Sorsly/ringRemote/datasheets/power.ods

state | component | current draw (A) | voltage (V) | time duration (ms) | comments | Continuous total life w/ 5.5mAh (h) | max number of transmissions
tx | ATBTLC1000-ZR | 6.20E-03 | 1.8 | 10 | 3dBm on ch37 | 0.498278673672767 | 179380.322522196
 | PIC12 | 5.80E-05 | 1.8 |  | D015 mode. E: Crap, doesn’t have UART with hardware flow control. Required.
 | MAX32660 |  |  |  | dynamic current, active and deep sleep mode. Has UART with hardware flow control, can use an ultra-low power nanoring osc
 | Lite-On LED | 4.78E-03 |  | 1
idle
