Sorsly/ringRemote/mech/Backup (1) of ringRemote.SLDASM

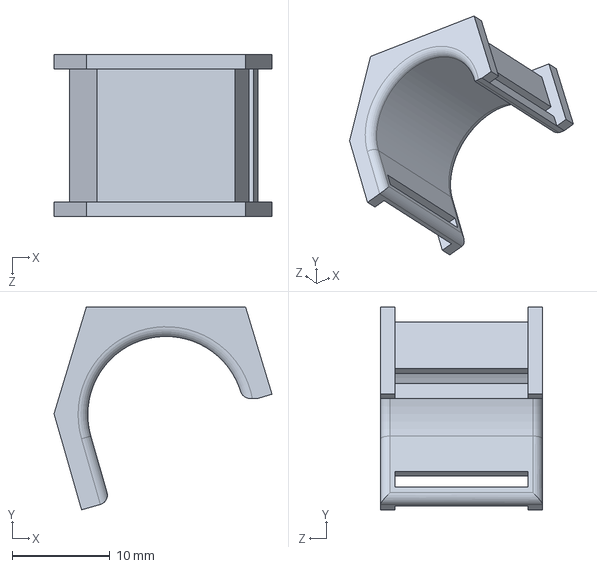
[picture p1: CAD file, 2019-02-18]
mech/Backup (1) of ringRemote.SLDASM
22.3 x 20.8 x 16.6 mm
