Sorsly/ringRemote/mech/Assem1.SLDASM

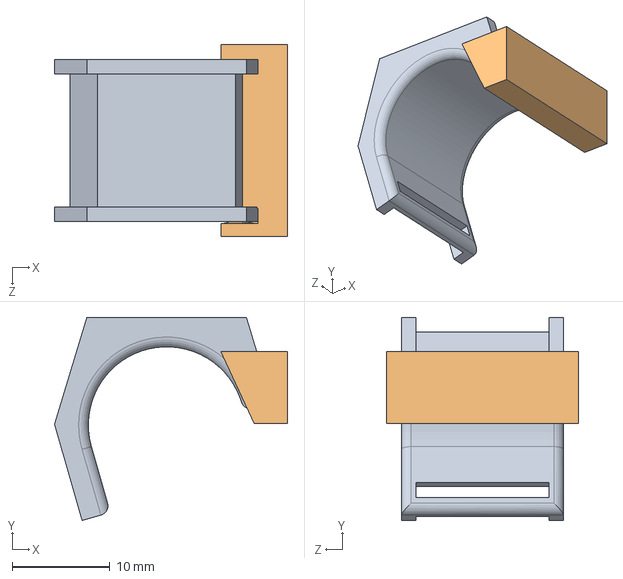
[picture p2: CAD file, 2019-02-18]
mech/Assem1.SLDASM
23.8 x 20.8 x 19.6 mm
tempStand
