Sorsly/ringRemote/mech/Backup (1) of tempStand.sldprt

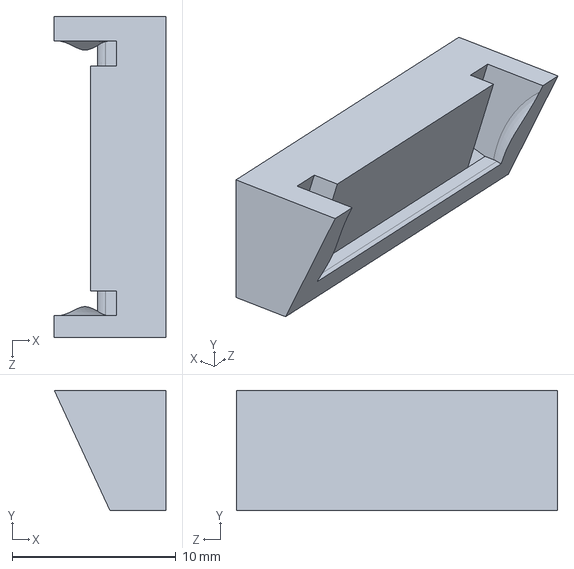
[picture p3: CAD file, 2019-02-18]
mech/Backup (1) of tempStand.sldprt
6.81 x 7.35 x 19.6 mm
