Sorsly/ringRemote/models/Conn_Amphenol_10118192-0001LF/9edb737dc0cf094d5b80fefa4222fe64e3edb863.step

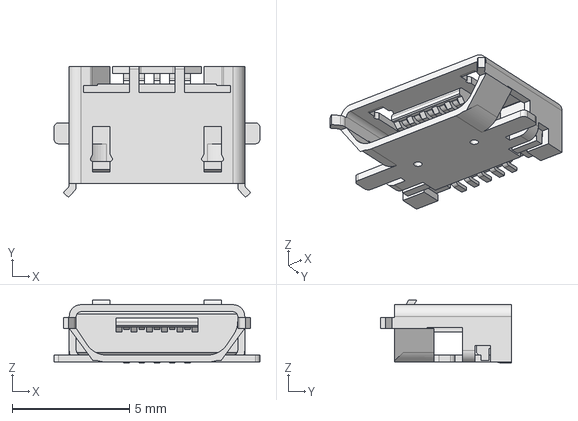
[picture p4: CAD file, 2019-01-07]
models/Conn_Amphenol_10118192-0001LF/9edb737dc0cf094d5b80fefa4222fe64e3edb863.step
8.80 x 5.59 x 2.67 mm
