Sorsly/ringRemote/models/Diode_Panasonic_DB2J31400L/6dc355337178d18dbc62b4daa5e0440a51f9a382.step

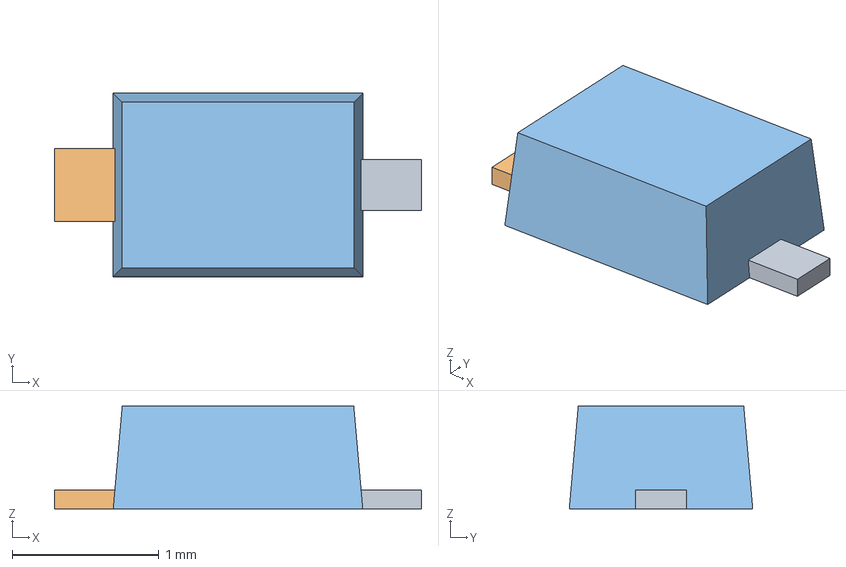
[picture p5: CAD file, 2019-01-07]
models/Diode_Panasonic_DB2J31400L/6dc355337178d18dbc62b4daa5e0440a51f9a382.step
2.50 x 1.25 x 0.7 mm
