Sorsly/ringRemote/models/IC_Microchip_PIC12F1501-I_MS/42fe51aefd6d4e30dba15b1fc3f1184283acede2.step

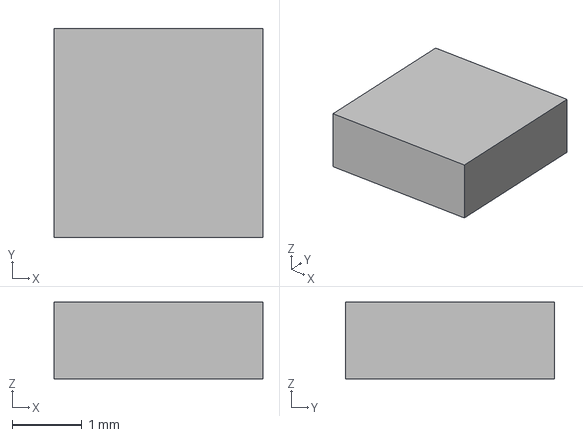
[picture p6: CAD file, 2019-01-06]
models/IC_Microchip_PIC12F1501-I_MS/42fe51aefd6d4e30dba15b1fc3f1184283acede2.step
3.00 x 3.00 x 1.10 mm
