Sorsly/ringRemote/(list of files, cad)

Other CAD files:
mech/Backup (3) of ringRemote.SLDASM
mech/Backup (2) of ringRemote.SLDASM
mech/ringRemote.SLDASM
mech/Part2.SLDPRT
mech/Part1.sldprt
mech/tempStand.sldprt
mech/Backup (2) of tempStand.sldprt
models/IC_Microchip_PIC12F1501-I_MS/c4145753d60ecc28152f750d2ed054111b1eff16.step
mech/stl/ringRemote.STL
mech/tempStand.STL
