Sorsly/ringRemote/kicad/pdf/bottomLayer.pdf

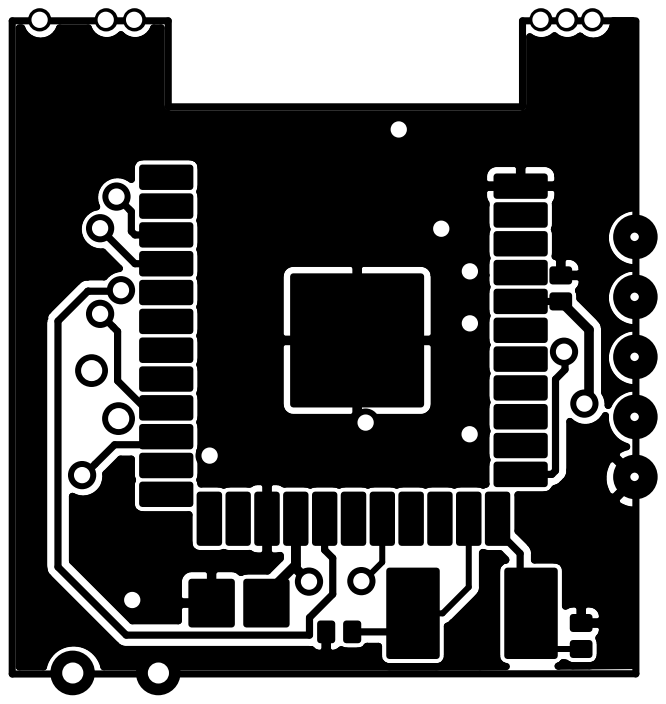
[picture p7: page 1]
