Sorsly/ringRemote/kicad/pdf/hmi2.pdf

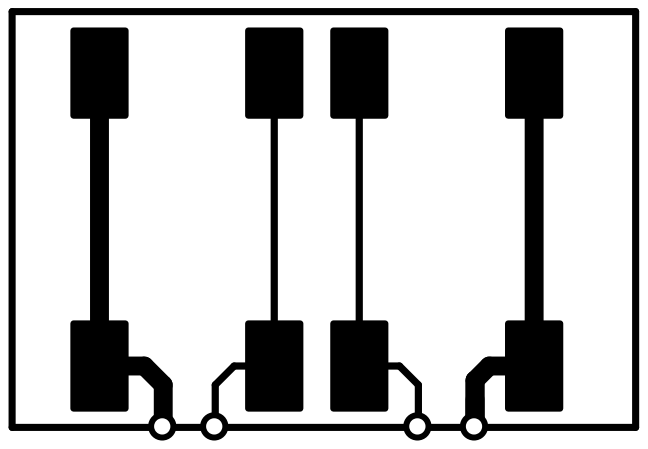
[picture p10: page 1]

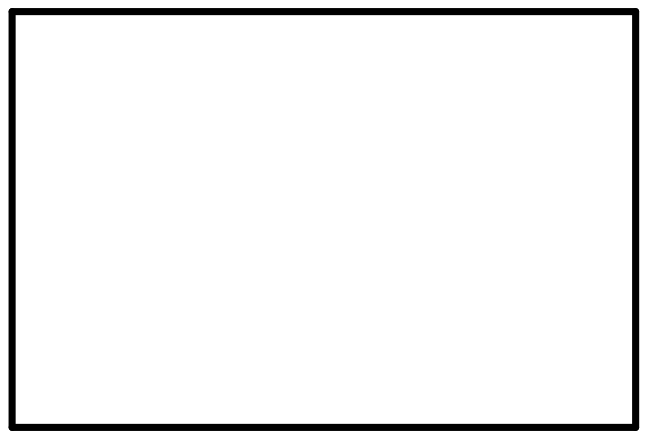
[picture p11: page 2]
