Sorsly/ringRemote/kicad/ringRemote.kicad_pcb

## KiCad design kicad/ringRemote.kicad_pcb (2019-02-18)

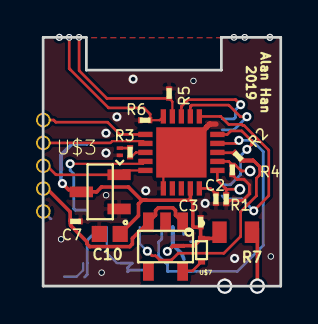
[picture p12: board ringRemote.kicad_pcb from above]

Board: 4 copper layers, 13.2 x 13.8 mm, 23 parts (0 on the bottom side), 24 nets.

Parts:
C2, C3, C7: 1uF; 0201
C4: 0.1uF; 0201
C5, C6: 4pF; 0201
C9, C10: 10uF; 0402
D1: ORANGE; LED-0201
R1, R2, R3, R4, R5, R6: 100k; 0201
R7: 1.8k; 0805
U$1: MAX32660; T2044+5C
U$2: ATBTLC1000-ZR110CA
U$3: TPS3839G25; 3-SOT-23
U$4: TLV700; SOT-23-THIN
U$6: 1X5_1.27MM
U$7: DB2731400L; SSSMINI2
Y1: 32.768kHz; CRYSTAL-SMD-3.2X1.5MM

Connections:
+5V: C7.1, U$4.P$1, U$4.P$3, U$6.P$2
/AO_GPIO_0_WAKE: U$1.P$4, U$2.P$1
/BT_CTS: U$1.P$15, U$2.P$20
/BT_RTS: U$1.P$16, U$2.P$21
/BT_RXD: U$1.P$18, U$2.P$14
/BT_TXD: U$1.P$17, U$2.P$15
/CLKSRC: C6.1, U$2.P$33, Y1.P$1
/C_EN: R2.2, U$1.P$13
/MAXRST: U$1.P$5, U$3.P$2, U$6.P$3
/PB1: R1.1, U$1.P$11
/PB2: R4.1, U$1.P$12
/PB3: R5.1, U$1.P$19
/PB4: R6.1, U$1.P$20
/SWDCLK: U$1.P$1, U$6.P$5
/SWDIO: U$1.P$2, U$6.P$4
/WAKEMONITOR: U$1.P$14, U$2.P$28
GND: C2.2, C3.2, C4.2, C5.2, C6.2, C7.2, C9.2, C10.2, D1.C, R1.2, R4.2, R5.2, R6.2, U$1.P$0, U$1.P$6, U$2.P$11, U$2.P$26, U$2.P$35, U$3.P$1, U$4.P$2, U$6.P$1
unnamed: C2.1, U$1.P$10
unnamed: C5.1, U$2.P$34, Y1.P$2
unnamed: D1.A, R3.2
unnamed: R2.1, U$2.P$30
unnamed: R3.1, U$1.P$3
unnamed: U$4.P$5, U$7.P$2
VCC: C3.1, C4.1, C9.1, C10.1, R7.2, U$1.P$9, U$2.P$7, U$2.P$27, U$3.P$3, U$7.P$1
