Sorsly/ringRemote/kicad/hmi1.kicad_pcb

## KiCad design kicad/hmi1.kicad_pcb (2019-01-25)

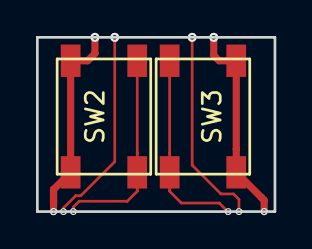
[picture p13: board hmi1.kicad_pcb from above]

Board: 2 copper layers, 13.2 x 9.7 mm, 3 parts (0 on the bottom side), 3 nets.

Parts:
FRAME1: FRAME-LETTERNO_PACKAGE; DUMMY
SW2, SW3: SW_SPST_0; RS-187R05A2-DS MT RT

Connections:
/PB2: SW3.1, SW3.2
/PB3: SW2.1, SW2.2
VCC: SW2.3, SW2.4, SW3.3, SW3.4
