Sorsly/ringRemote/kicad/hmi2.kicad_pcb

## KiCad design kicad/hmi2.kicad_pcb (2019-01-24)

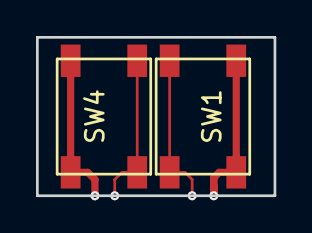
[picture p14: board hmi2.kicad_pcb from above]

Board: 2 copper layers, 13.2 x 8.8 mm, 3 parts (0 on the bottom side), 3 nets.

Parts:
FRAME1: FRAME-LETTERNO_PACKAGE; DUMMY
SW1, SW4: SW_SPST_0; RS-187R05A2-DS MT RT

Connections:
/PB1: SW1.1, SW1.2
/PB4: SW4.1, SW4.2
VCC: SW1.3, SW1.4, SW4.3, SW4.4
