Sorsly/ringRemote/eagle/ringRemote.brd

## EAGLE design eagle/ringRemote.brd (2019-01-21)

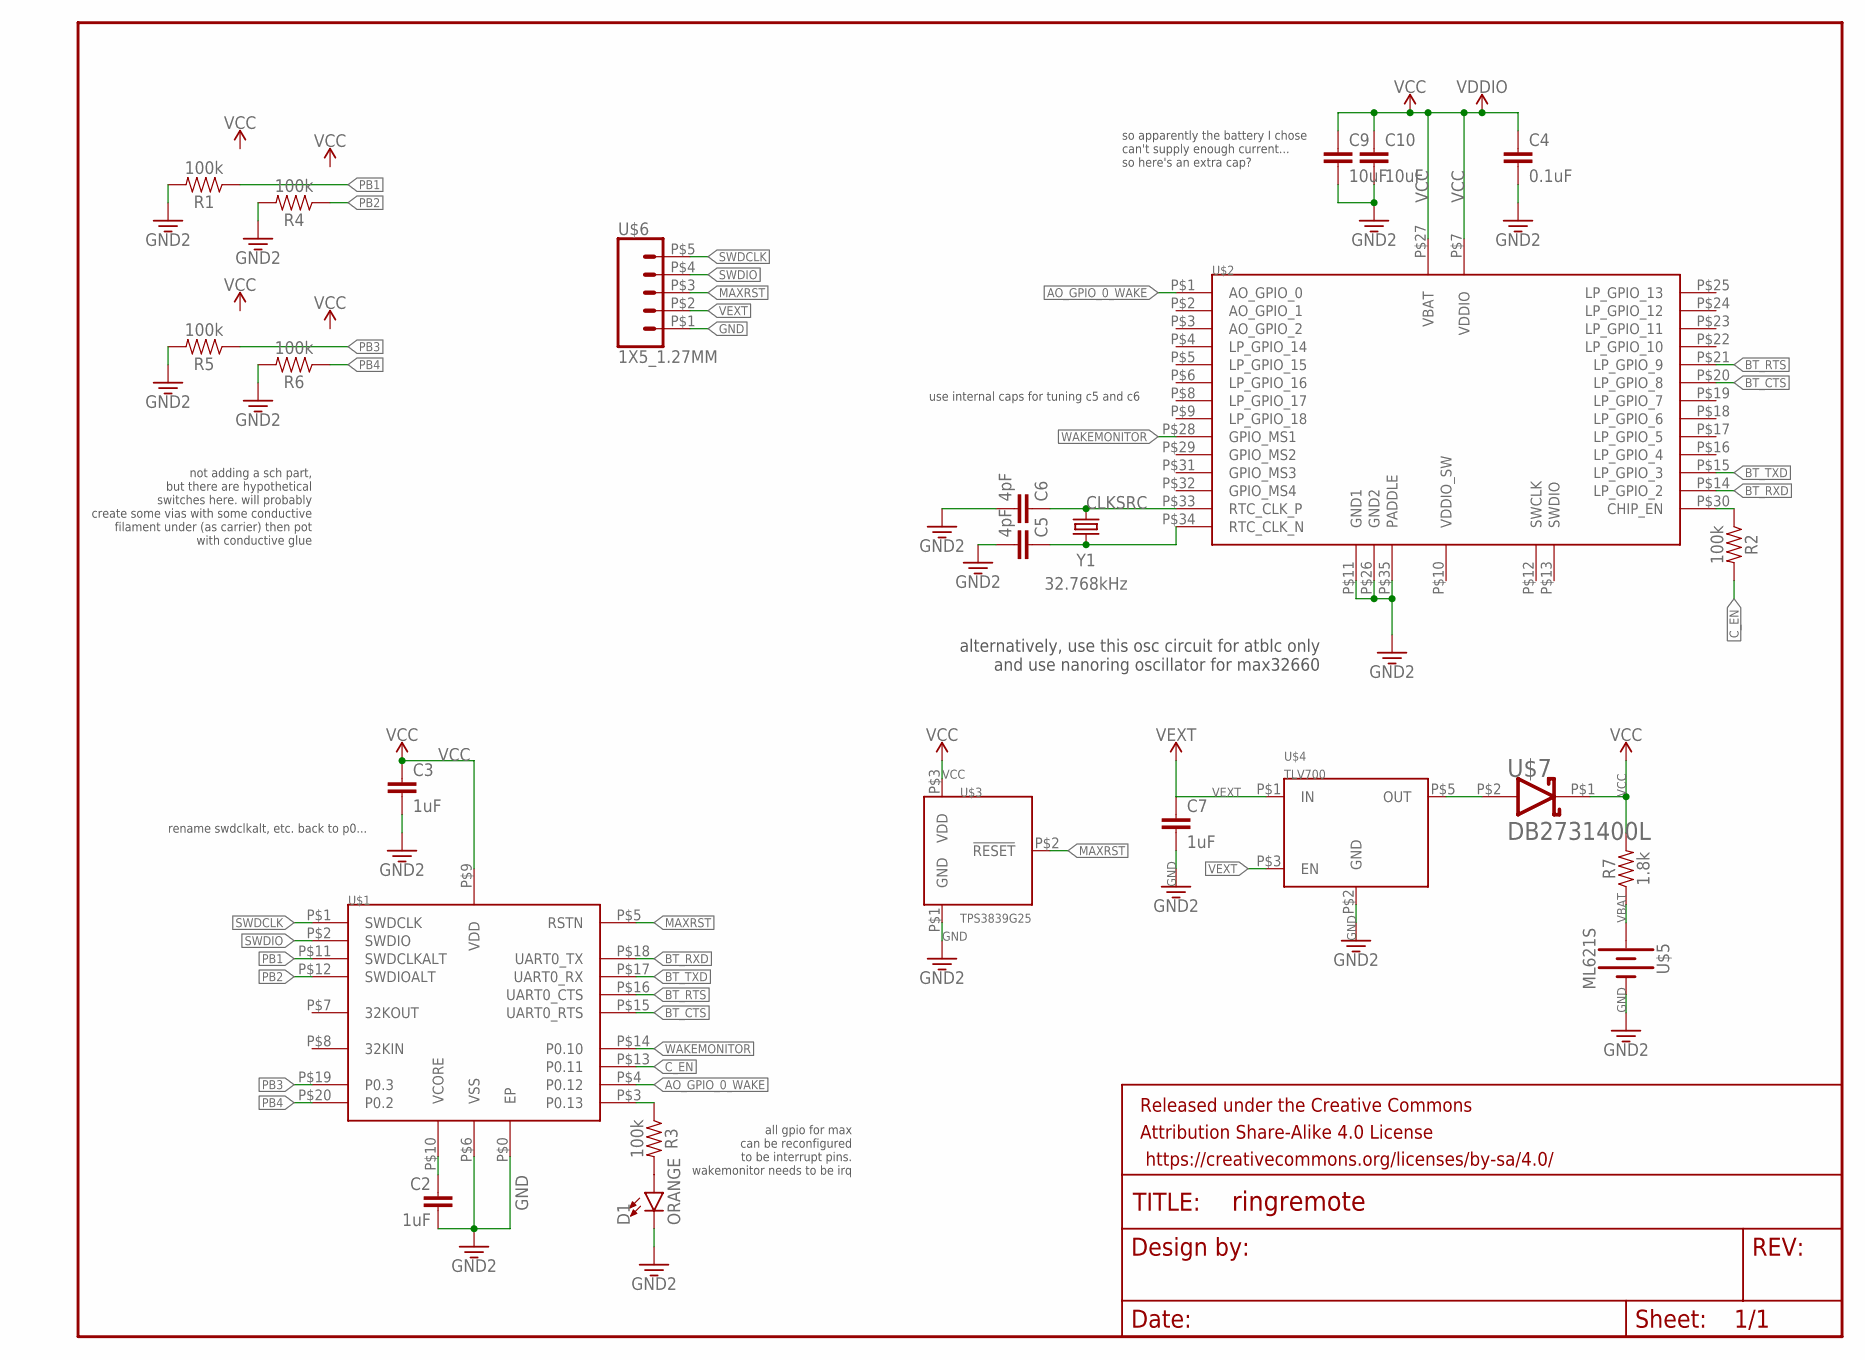
[picture p15: schematic ringRemote.sch]

Parts:
C2, C3, C7: 1uF; 0201
C4: 0.1uF; 0201
C5, C6: 4pF; 0201
C9, C10: 10uF; 0402
D1: ORANGE; LED-0201
FRAME1: FRAME-LETTERNO_PACKAGE; DUMMY
R1, R2, R3, R4, R5, R6: 100k; 0201
R7: 1.8k; 0805
U$1: MAX32660; T2044+5C
U$2: ATBTLC1000-ZR110CA
U$3: TPS3839G25; 3-SOT-23
U$4: TLV700; SOT-23-THIN
U$5: ML621S
U$6: 1X5_1.27MM
U$7: DB2731400L; SSSMINI2
Y1: 32.768kHz; CRYSTAL-SMD-3.2X1.5MM

Connections:
AO_GPIO_0_WAKE: U$1.P$4 (P0.12), U$2.P$1 (AO_GPIO_0)
BT_CTS: U$1.P$15 (UART0_RTS), U$2.P$20 (LP_GPIO_8)
BT_RTS: U$1.P$16 (UART0_CTS), U$2.P$21 (LP_GPIO_9)
BT_RXD: U$1.P$18 (UART0_TX), U$2.P$14 (LP_GPIO_2)
BT_TXD: U$1.P$17 (UART0_RX), U$2.P$15 (LP_GPIO_3)
CLKSRC: C6.1, U$2.P$33 (RTC_CLK_P), Y1.P$1 (1)
C_EN: R2.2, U$1.P$13 (P0.11)
GND: C2.2, C3.2, C4.2, C5.2, C6.2, C7.2, C9.2, C10.2, D1.C, R1.2, R4.2, R5.2, R6.2, U$1.P$0 (EP), U$1.P$6 (VSS), U$2.P$11 (GND1), U$2.P$26 (GND2), U$2.P$35 (PADDLE), U$3.P$1 (GND), U$4.P$2 (GND), U$5.P$2 (-), U$6.P$1 (1)
MAXRST: U$1.P$5 (RSTN), U$3.P$2 (!RESET), U$6.P$3 (3)
unnamed: C2.1, U$1.P$10 (VCORE)
unnamed: C5.1, U$2.P$34 (RTC_CLK_N), Y1.P$2 (2)
unnamed: R3.1, U$1.P$3 (P0.13)
unnamed: R2.1, U$2.P$30 (CHIP_EN)
unnamed: D1.A, R3.2
unnamed: U$4.P$5 (OUT), U$7.P$2 (ANODE)
PB1: R1.1, U$1.P$11 (SWDCLKALT)
PB2: R4.1, U$1.P$12 (SWDIOALT)
PB3: R5.1, U$1.P$19 (P0.3)
PB4: R6.1, U$1.P$20 (P0.2)
SWDCLK: U$1.P$1 (SWDCLK), U$6.P$5 (5)
SWDIO: U$1.P$2 (SWDIO), U$6.P$4 (4)
VBAT: R7.1, U$5.P$1 (+)
VCC: C3.1, C4.1, C9.1, C10.1, R7.2, U$1.P$9 (VDD), U$2.P$7 (VDDIO), U$2.P$27 (VBAT), U$3.P$3 (VDD), U$7.P$1 (CATHODE)
VEXT: C7.1, U$4.P$1 (IN), U$4.P$3 (EN), U$6.P$2 (2)
WAKEMONITOR: U$1.P$14 (P0.10), U$2.P$28 (GPIO_MS1)

Notes on the sheet:
alternatively, use this osc circuit for atblc only and use nanoring oscillator for max32660
all gpio for max can be reconfigured to be interrupt pins. wakemonitor needs to be irq
use internal caps for tuning c5 and c6
not adding a sch part, but there are hypothetical switches here. will probably create some vias with some conductive filament under (as carrier) then pot with conductive glue
rename swdclkalt, etc. back to p0...
so apparently the battery I chose can't supply enough current... so here's an extra cap?

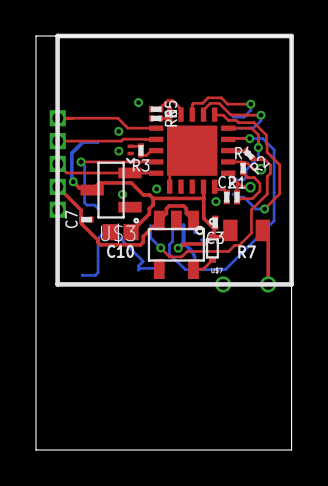
[picture p16: board ringRemote.brd from above]

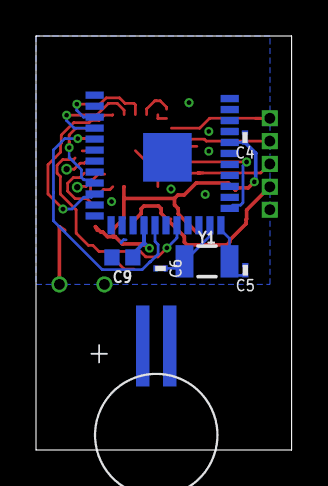
[picture p17: board ringRemote.brd from below]

Board: 2 copper layers, 14.2 x 23.0 mm, 25 parts (7 on the bottom side), 25 nets.
