Sorsly/ringRemote/eclipse/ringRemote/main.c

/**
 * @file    main.c
 * @brief   Hello World!
 * @details This example uses the UART to print to a terminal and flashes an LED.
 */

/*******************************************************************************
 * Copyright (C) 2016 Maxim Integrated Products, Inc., All Rights Reserved.
 *
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
 * Except as contained in this notice, the name of Maxim Integrated
 * Products, Inc. shall not be used except as stated in the Maxim Integrated
 * Products, Inc. Branding Policy.
 *
 * The mere transfer of this software does not imply any licenses
 * of trade secrets, proprietary technology, copyrights, patents,
 * trademarks, mask work rights, or any other form of intellectual
 * property whatsoever. Maxim Integrated Products, Inc. retains all
 * ownership rights.
 *
 * $Date: 2018-08-09 23:45:02 +0000 (Thursday, 09 August 2018) $
 * $Revision: 36818 $
 *
 ******************************************************************************/

/***** Includes *****/
#include <stdio.h>
#include <stdint.h>
#include <stdbool.h>

//delay libraries
#include "mxc_config.h"
#include "mxc_delay.h"

#include "tmr.h"
#include "tmr_utils.h"

//led library
#include "led.h"

//required libraries
#include "board.h"  //this NEEDS to be before gpio.h apparently
#include "gpio.h"


/***** Definitions *****/
//reminder that all pins listed here are SOFTWARE, not HARDWARE
#define PB1_PIN     PIN_9
#define PB2_PIN     PIN_8
#define PB3_PIN     PIN_3
#define PB4_PIN     PIN_2
#define LED_PIN     PIN_13

#define THRESH      10      //ms
#define TMR0        MXC_TMR0

#define PAYLOAD_SIZE 11     //may change depending on encryption algos

/***** Globals *****/

/***** Functions *****/

bool debounce(bool *prevSt, int *tStart, bool currSt) {
    if(currSt != *prevSt) {     //change has occured
        TMR_Enable(TMR0);       //enables timer on change
        *tStart = TMR_GetCount(TMR0);
        *prevSt = currSt;
    } else {
        if((TMR_GetCount(TMR0) - *tStart) > THRESH) {
            *prevSt = currSt;
            currSt = !currSt;
            TMR_Disable(TMR0);  //disables timer after settling
        }
    }

    return currSt;
}

void encrypt(uint8_t *payload, int num) {  //only used to encrypt the custom data payload
    //TODO

}

void loadPayload(uint8_t *adv_data, uint8_t *payload) {
    packetSz = sizeof(adv_data);
    payloadSz = sizeof(payload);
    
    for(int i=0; i<payloadSz; i++) {
        adv_data[packetSz - payloadSz + i] = payload[i];    //load payload into packet
    }
}

//inits atbtlc device
void btInit() {
    //TODO
    at_ble_addr_t addr = {AT_BLE_ADDRESS_PUBLIC,
        {} };   //add in a valid addr (not sure what that means)
    at_ble_init();  //I think this is the actual init function. just need to include libraries
    at_ble_addr_set(&addr);

}

//tells atbtlc to send bytes
void btTx(int num) {   //TODO
    for(int i=0; i<num; i++) {
        LED_On(0);  //just for the evalboard?
        mxc_delay(MXC_DELAY_MSEC(50));
        LED_Off(0);  //just for the evalboard?
        mxc_delay(MXC_DELAY_MSEC(50));
    }
    //random, arbitrary uuid: 6c1a3f30-484a-11e9-b475-0800200c9a66
    //generated by: https://www.famkruithof.net/uuid/uuidgen
    /*
     * leaving these arrays to show how adv_data[] was derived
    uint8_t uuid[] = {      //total 18bytes
        0x11,   //data length
        0x07,   //complete list of 128-bit uuids available
        0x66, 0x9a, 0x0c, 0x20, 0x00, 0x08, 0x75, 0xb4, 0xe9, 0x11, 0x4a, 0x48, 0x30, 0x3f, 0x1a, 0x6c  //little endian
    };
    uint8_t name[] = {      //total 12bytes
        0x0b,     //data length
        0x0c,   //full device name
        0x72, 0x69, 0x6e, 0x67, 0x52, 0x65, 0x6d, 0x6f, 0x74, 0x65      //big endian (ringRemote)
    };
    uint8_t data[13] = {    //total 18bytes; for uuid only
        0x11,   //data length
        0xff,   //custom data
        0xff, 0xff, 0xff, 0xff, 0xff, 0xff, 0xff, 0xff, 0xff, 0xff, 0xff //allocate space for the encrypted data
    };
    uint8_t data[18] = {    //total 18bytes; for name only
        0x11,   //data length
        0xff,   //custom data
        0xff, 0xff, 0xff, 0xff, 0xff, 0xff, 0xff, 0xff, 0xff, 0xff, 0xff, 0xff, 0xff, 0xff, 0xff, 0xff  //allocate space for the encrypted data
    };
    */

    uint8_t adv_data[] = {  //cannot exceed total 31bytes
        /* commenting for test purposes only
        0x11,   //data length
        0x07,   //complete list of 128-bit uuids available
        0x66, 0x9a, 0x0c, 0x20, 0x00, 0x08, 0x75, 0xb4, 0xe9, 0x11, 0x4a, 0x48, 0x30, 0x3f, 0x1a, 0x6c,  //little endian
        */
        0x0b,     //data length
        0x0c,   //full device name
        0x72, 0x69, 0x6e, 0x67, 0x52, 0x65, 0x6d, 0x6f, 0x74, 0x65,      //big endian (ringRemote)
        0x11,   //data length
        0xff,   //custom data
        0xff, 0xff, 0xff, 0xff, 0xff, 0xff, 0xff, 0xff, 0xff, 0xff, 0xff //allocate space for the encrypted data
    };
    
    //uint8_t payload[PAYLOAD_SIZE];
    //encrypt(payload, num);

    uint8_t payload[PAYLOAD_SIZE] = {   //test purposes only
        0x00, 0x01, 0x02, 0x03, 0x04, 0x05, 0x06, 0x07, 0x08, 0x09, 0x0a
    };


    loadPayload(adv_data, payload);

    at_ble_adv_data_set(    //set byte to be sent
            adv_data,
            sizeof(adv_data),
            NULL,
            0
    );

    at_ble_adv_start(   //start advertising
            AT_BLE_ADV_TYPE_NONCONN_UNDIRECTED,   //type; no scan response, non connectable, undirected
            AT_BLE_ADV_BROADCASTER_MODE,   //mode; non discoverable and non connectable
            NULL,   //known peer address; not used for selected settings
            AT_BLE_ADV_FP_FILTER_BOTH,   //advertising filter policy; scan and connect white listed only
            100,   //interval; 100ms (temp arbitrary value. //TODO math for rc rise time)
            0x00,   //timeout; disabled (0x00) because invalid for current settings
            false   //disable_randomness; false is better for noise immunity
    );      
    //delayPlaceholder();    //some delay so data can be advertised once (might not be needed because start contains timing info)
    at_ble_adv_stop();      //stop advertising
    //note: opting not to use update_on_the_fly because of battery concerns
    
}

//timer interrupt
void gpio_isr(void *cbdata)
{
    //cbdata.ten = 1;   //enable timer
    //TMR_Enable((mxc_tmr_regs_t*)cbdata);   //enable timer
    TMR_Enable(TMR0);   //enable timer
}

//timer init
void tmrInit(void) {
    tmr_cfg_t tmr;
    unsigned clk_shift = 0;
    uint64_t max_us;
    uint32_t ticks; //ticks temp var
    unsigned long us = MSEC(THRESH);    //seems to work with MSEC

    /* Find the proper clock shift for timer */
    do {
        max_us = (uint64_t)((0xFFFFFFFFUL / ((uint64_t)PeripheralClock >> clk_shift++)) * 1000000UL);
    } while (us > max_us);
    clk_shift--;

    TMR_Disable(TMR0);
    TMR_Init(TMR0, (tmr_pres_t)clk_shift, 0);
    
    //ms to ticks
    TMR_GetTicks(TMR0, THRESH, TMR_UNIT_MILLISEC, &ticks);  //get ticks from ms
    
    //define tmr
    tmr.mode = TMR_MODE_ONESHOT;
    tmr.cmp_cnt = ticks;    //timer mode?
    tmr.pol = 0;    //compare register value in timer ticks. not used
    
    TMR_Config(TMR0, &tmr); //configure tmr as TMR0

    //use "TMR_Enable(TMR0);" to enable timer
}

//interrupt pin init
void pbInit(gpio_cfg_t *pb, int pb_pin) {   //check if pb_pin is actually int
    pb->port = PORT_0;
    pb->mask = pb_pin;
    pb->pad = GPIO_PAD_PULL_DOWN;
    pb->func = GPIO_FUNC_IN;
    GPIO_Config(pb);
    
    //GPIO_RegisterCallback(&pb, gpio_isr, &tElapsed);
    //GPIO_RegisterCallback(&pb, gpio_isr, &TMR0);
    GPIO_RegisterCallback(pb, gpio_isr, NULL);
    
    GPIO_IntConfig(pb, GPIO_INT_EDGE, GPIO_INT_BOTH); //reads on falling and rising
    
    GPIO_IntEnable(pb);
    NVIC_EnableIRQ((IRQn_Type)MXC_GPIO_GET_IRQ(PORT_0));
}

int main(void) {
//declarations
    gpio_cfg_t pb1, pb2, pb3, pb4;

    btInit();

    tmrInit();

    pbInit(&pb1, PB1_PIN);
    pbInit(&pb2, PB2_PIN);
    pbInit(&pb3, PB3_PIN);
    pbInit(&pb4, PB4_PIN);

//loop
    while(1) {
        if(TMR_IntStatus(TMR0)) {   //check if TMR0 finished the cnt (if debounce success)
            //pass which switch got pushed to the bt func
            if(GPIO_InGet(&pb1)) {
                btTx(1);
            } else if(GPIO_InGet(&pb2)) {
                btTx(2);
            } else if(GPIO_InGet(&pb3)) {
                btTx(3);
            } else if(GPIO_InGet(&pb4)) {
                btTx(4);
            }

            //TMR_IntClear(TMR0);     //unnecessary because interrupt clears auto?
        }
    }
}
