Sorsly/ringRemote/(commit log)

2019-01-06 added a todo list; did some thinking for the HMI pushbuttons
    [ringRemote.brd, ringRemote.sch]
2019-01-06 added to bom: battery supervisor, charging circuit components; put components on board space to estimate stuff
    [ringRemote.brd, ringRemote.sch]
2019-01-06 moved some datasheets from local/proj
    [power.ods]
2019-01-06 added battery supervisor part, wired it up
    [ringRemote.brd, ringRemote.sch]
2019-01-07 made a new sheet, moved all power stuff to second sheet; added charger circuit; added connector; added battery. pretty much just need to determine the programming interface before I start doing board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
    [ringRemote.brd, ringRemote.sch]
2019-01-07 some models from octopart
    [6dc355337178d18dbc62b4daa5e0440a51f9a382.step, 9edb737dc0cf094d5b80fefa4222fe64e3edb863.step]
2019-01-07 misc save
    [ringRemote.brd]
2019-01-14 made rough layout of board; swapped some pins for pushbuttons in sch (to atbtlc); understood programming workflow a bit better (likely using SWD instead of i2c)
    [ringRemote.brd, ringRemote.sch]
2019-01-14 created mech directory
    [ringRemote.SLDASM]
2019-01-16 think I moved the pb's back to MAX32660 (using the i2c lines because they're not needed)
    [ringRemote.brd, ringRemote.sch]
2019-01-19 pretty much finished the board; swapped diode out for a smaller package
    [ringRemote.brd, ringRemote.sch]
2019-01-21 tried to create some vias for the pushbuttons, these need to be routed offboard (past castellated edge near antenna section); created rev1 of mech model (this needs to be bigger and smoother, hurts m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
    [ringRemote.SLDASM, ringRemote.brd, ringRemote.sch]
2019-01-22 moved eagle files to subdir
    [ringRemote.brd, ringRemote.sch]
2019-01-22 some misc mech outputs
    [Backup (1) of ringRemote.SLDASM, Backup (2) of ringRemote.SLDASM, ringRemote.STL]
2019-01-22 switched over to kicad for 4-layer stuff
    [ringRemote.kicad_pcb, ringRemote.sch]
2019-01-22 switched over to kicad for 4-layer stuff
    *also fixed some clearance issues (set up some drc stuff)
    *wired out hmi traces towards antenna end
    *redefined board edge.cuts to suit custom shape better
    [ringRemote.kicad_pcb, ringRemote.sch]
2019-01-22 had to wire GND castellation to polypour; the border technically isn't filled
    [ringRemote.kicad_pcb]
2019-01-23 finished routing main board; changed programming castellations to circular; created subschematic for battery board
    [ringRemote.kicad_pcb, ringRemote.sch]
2019-01-23 finished battery board; added switch footprint to library; need to make symbol for switch and make switch board
    [battery.kicad_pcb, battery.sch, ringRemote.sch]
2019-01-24 added 4 pin spst switch and finished sch
    [ringRemote.kicad_pcb, ringRemote.sch]
2019-01-24 finished hmi boards
    [hmi1.kicad_pcb, hmi2.kicad_pcb]
2019-01-24 added pdfs of to-scale layouts (for design review)
    [printoutBoard.kicad_pcb]
2019-01-25 fixed MAX32660 footprint (was actually wrong, design reviews are good), updated to board; slightly nudged pb4 via away from pb3 via (drc error)
    [battery.sch, ringRemote.kicad_pcb, ringRemote.sch]
2019-01-25 misc fix
    [ringRemote.kicad_pcb]
2019-01-25 fixed the pb4 issue on the hmi1 side; also cleared drc after fiddling with rules
    [hmi1.kicad_pcb]
2019-01-25 ran drc on hmi2 (is good, no resubmit necessary); slightly moved battery on battery, drc on battery is fine (resubmit though)
    [battery.kicad_pcb]
2019-01-25 updated pdfs; bottom had to be mirrored this time because I forgot to last time; top has updated footprint for max
2019-02-17 changed some of how interrupts will work, etc.
2019-02-18 mech changes from before uh2019
    [Assem1.SLDASM, Backup (1) of ringRemote.SLDASM, Backup (1) of tempStand.sldprt, Backup (2) of ringRemote.SLDASM, Backup (2) of tempStand.sldprt, Backup (3) of ringRemote.SLDASM, Part1.sldprt, Part2.SLDPRT]
2019-02-18 moved code into a sub dir and added an eclipse workspace to save debug config; fixed compile errors
    [ringRemote.kicad_pcb]
2019-02-18 modified btTx to pulse LED distinguishing each switch; test succeededgit status! next, need to verify if debouncing is working properly
2019-02-19 changed bttx led delays and added macro for led pin
2019-03-17 finished code for basic bt functionality; cleaned up some old code; need to find encryption support and implement low power operation
